mrossini-ethz/MidnightSun/led-driver-pcb/v1.0/led-driver.kicad_pcb

## KiCad design led-driver-pcb/v1.0/led-driver.kicad_pcb (2014-11-07)

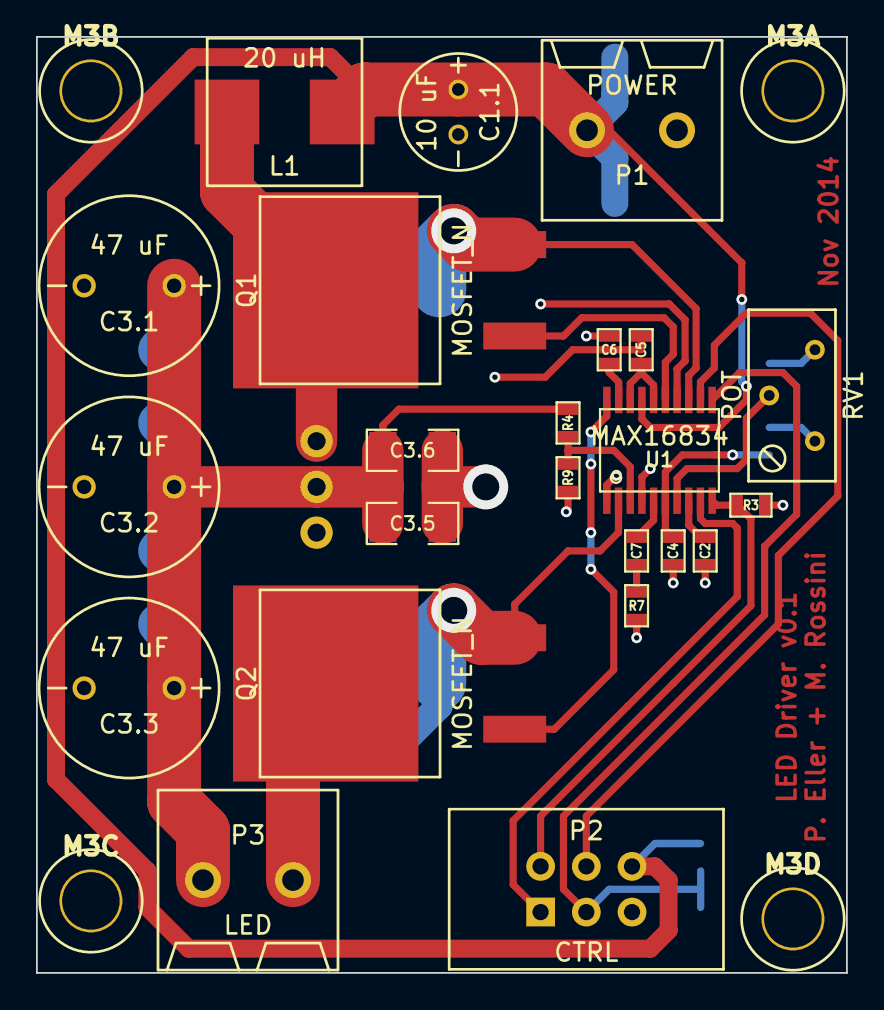
[picture p1: board led-driver.kicad_pcb from above]

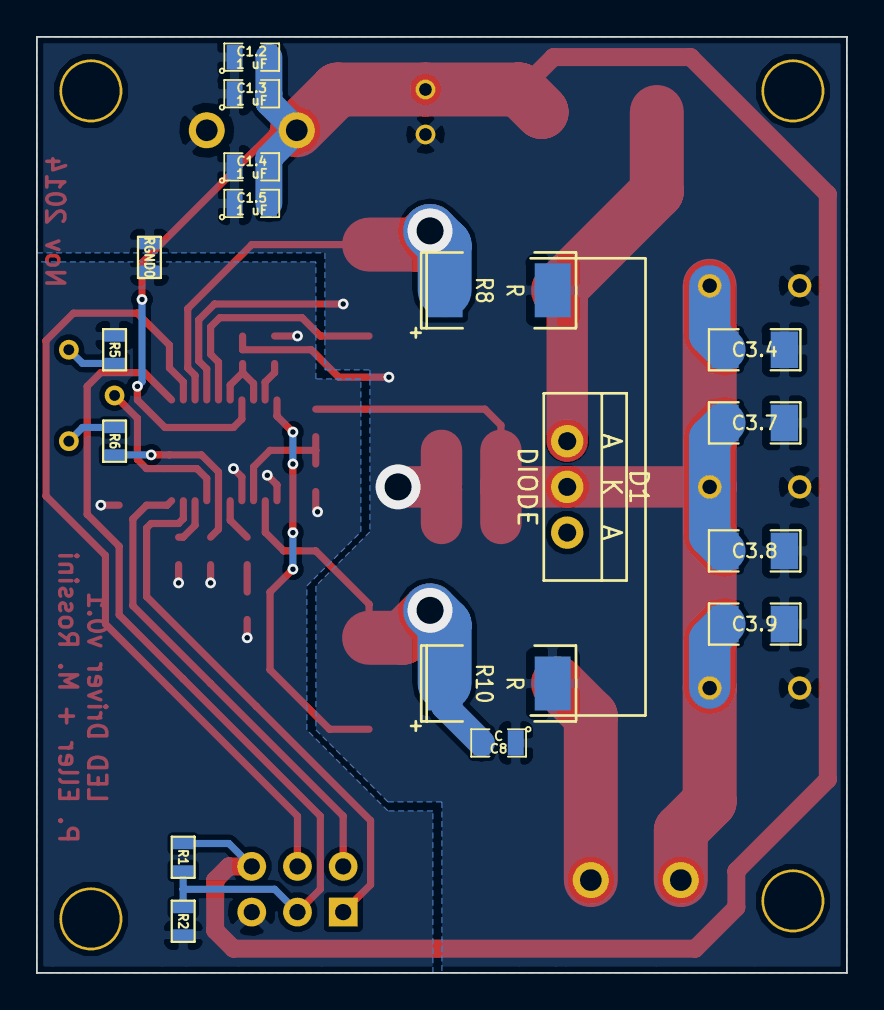
[picture p2: board led-driver.kicad_pcb from below]

Board: 2 copper layers, 45.0 x 52.0 mm, 44 parts (17 on the bottom side), 24 nets.

Parts:
C1.1: 10 uF; CP6.5x2.5
C1.2, C1.3, C1.4, C1.5: 1 uF; SM0805
C2, C4, C5, C6, C7: C; SM0603
C3.1, C3.2, C3.3: 47 uF; CP10x5
C3.4, C3.5, C3.6, C3.7, C3.8, C3.9: 1 uF; SM1206
C8: C; SM0805
D1: DIODE; TO220AB-Schottky
L1: 20 uH; LSMD8x8
M3A, M3B, M3C, M3D: P***; 1pin
P1: POWER; WAGO2P
P2: CTRL; PinHeader3x2
P3: LED; WAGO2P
Q1, Q2: MOSFET_N; D2PAK
R1, R2, R3, R4, R5, R6, R7, R9: R; SM0603
R8, R10: R; SM2512
RGND0: 0; SM0603
RV1: POT; RV_BOURNS
U1: MAX16834; tssop-20

Connections:
GND: C2.1, C4.1, C6.2, P2.5, R2.2, R3.2, R5.2, R7.2, R9.2, RGND0.2, U1.1, U1.4
GNDPWR: C1.1.2, C1.2.1, C1.3.1, C1.4.1, C1.5.1, C3.1.2, C3.2.2, C3.3.2, C3.4.1, C3.5.1, C3.6.1, C3.7.1, C3.8.1, C3.9.1, C5.2, C8.1, P1.1, R8.2, R10.2, RGND0.1, U1.14
unnamed: P2.4, U1.12
unnamed: R5.1, RV1.3
unnamed: C4.2, R6.1, U1.6
unnamed: P2.1, U1.9
unnamed: P2.2, R3.1, U1.10
unnamed: C2.2, U1.8
unnamed: RV1.2, U1.7
unnamed: R6.2, RV1.1
unnamed: P3.2, Q2.D
unnamed: P2.3, R1.2, R2.1, U1.11
unnamed: Q1.G, U1.15
unnamed: Q1.S, R8.1, U1.13
unnamed: Q2.G, U1.20
unnamed: R4.2, R9.1, U1.3
unnamed: C7.2, U1.5
unnamed: C7.1, R7.1
unnamed: C6.1, U1.19
unnamed: D1.1, L1.2, Q1.D
unnamed: C8.2, Q2.S, R10.1, U1.2
unnamed: C1.1.1, C1.2.2, C1.3.2, C1.4.2, C1.5.2, L1.1, P1.2, P2.6, R1.1, U1.17
unnamed: C5.1, U1.16, U1.18
unnamed: C3.1.1, C3.2.1, C3.3.1, C3.4.2, C3.5.2, C3.6.2, C3.7.2, C3.8.2, C3.9.2, D1.2, P3.1, R4.1
