mrossini-ethz/MidnightSun/firmware/cdc_pwm/led_ctrl.h

/*
             LUFA Library
     Copyright (C) Dean Camera, 2014.

  dean [at] fourwalledcubicle [dot] com
           www.lufa-lib.org
*/

/*
  Copyright 2014  Dean Camera (dean [at] fourwalledcubicle [dot] com)

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
  The author disclaims all warranties with regard to this
  software, including all implied warranties of merchantability
  and fitness.  In no event shall the author be liable for any
  special, indirect or consequential damages or any damages
  whatsoever resulting from loss of use, data or profits, whether
  in an action of contract, negligence or other tortious action,
  arising out of or in connection with the use or performance of
  this software.
*/

/** \file
 *
 *  Header file for VirtualSerial.c.
 */

#ifndef _VIRTUALSERIAL_H_
#define _VIRTUALSERIAL_H_

	/* Includes: */
		#include <avr/io.h>
		#include <avr/wdt.h>
		#include <avr/power.h>
		#include <avr/interrupt.h>
		#include <string.h>
		#include <stdio.h>

		#include "Descriptors.h"

		#include <LUFA/Drivers/USB/USB.h>
		#include <LUFA/Platform/Platform.h>

        #include <../../firmware/led-ctrl/macros.h>
        #include <../../firmware/led-ctrl/lookup.h>

	/* Macros: */
		/** LED mask for the library LED driver, to indicate that the USB interface is not ready. */
		#define LEDMASK_USB_NOTREADY      LEDS_LED1

		/** LED mask for the library LED driver, to indicate that the USB interface is enumerating. */
		#define LEDMASK_USB_ENUMERATING  (LEDS_LED2 | LEDS_LED3)

		/** LED mask for the library LED driver, to indicate that the USB interface is ready. */
		#define LEDMASK_USB_READY        (LEDS_LED2 | LEDS_LED4)

		/** LED mask for the library LED driver, to indicate that an error has occurred in the USB interface. */
		#define LEDMASK_USB_ERROR        (LEDS_LED1 | LEDS_LED3)

	/* Function Prototypes: */
		void SetupHardware(void);
        void cdc_receive(void);
		void EVENT_USB_Device_Connect(void);
		void EVENT_USB_Device_Disconnect(void);
		void EVENT_USB_Device_ConfigurationChanged(void);
		void EVENT_USB_Device_ControlRequest(void);

#endif
