mrossini-ethz/MidnightSun/(commit log)

2014-10-21 Added the current version of the boost converter simulation and a script to calculate the device values for it.
2014-10-21 Edited simulation and parameter script to match the 24 V power supply specs.
2014-10-21 Added a KiCAD project and the schematic for the LED driver.
    [led-driver.sch]
2014-10-22 updated values in schema
    [led-driver.sch]
2014-10-31 Added the MOSFET component datasheet.
2014-10-31 Added footprints to the PCB of the LED driver and set up the PCB design.
    [led-driver.kicad_pcb, led-driver.sch]
2014-11-02 arranged components on PCB
    [led-driver.kicad_pcb]
2014-11-02 updated components on PCB
    [led-driver.kicad_pcb]
2014-11-02 Added a 3x2 pin header to the footprint library.
2014-11-02 Added power ratings for resistors in parameter calculater.
2014-11-03 Added components list for LED driver PCB.
2014-11-03 updated layout, added screwholes
    [led-driver.kicad_pcb]
2014-11-03 Finished the PCB design.
    [led-driver.kicad_pcb]
2014-11-04 Improved the params file for the LED driver by rounding values and adding more component values.
2014-11-04 added pwrgnd layer
    [led-driver.kicad_pcb, led-driver.sch]
2014-11-04 Optimized design and put capacitor C1.1 also to power ground.
    [led-driver.kicad_pcb, led-driver.sch]
2014-11-04 Made more optimizations.
    [led-driver.kicad_pcb, led-driver.sch]
2014-11-04 Enhanced the LED driver parameter script to show temperatures of components.
2014-11-04 Added calculation of capacitor ripple currents and added some component suggestions.
    [led-driver.sch]
2014-11-05 Exchanged capacitors and added new ones to allow for current ripple and to minimize ESR.
    [led-driver.kicad_pcb, led-driver.sch]
2014-11-05 Corrected the footprint of the MOSFETs.
    [led-driver.kicad_pcb]
2014-11-07 Moved two ceramic capacitors closer to the diode.
    [led-driver.kicad_pcb]
2014-12-03 added firmware project; first version of PWM
2014-12-15 Added an intensity lookup table to smoothly control the LED intensity.
2014-12-16 Firmware: Changed PWM mode to phase correct such that 0 % and 100 % duty cycle are possible.
    [main.c]
2015-02-16 Added a macros.h header file to simplify the setting of flags in registers and the handling of GPIO pins. Converted project to the Arduino Uno/Leonardo at the same time.
2015-02-17 Added a USART interface that at the moment just echos the input. Had to fix the system clock prescaling that was previously broken while doing so.
    [interrupt.c, interrupt.h, main.c, usart.c, usart.h]
2015-02-21 Changed the PWM control from fixed frequency to variable frequency below a certain threshold intensity. This enhances resolution at the low end.
    [main.c, usart.c]
2015-05-18 arduino leonardo lufa
2015-05-21 Added the Arduino Boards to the payment list.
2015-05-21 Added wishlist for LED driver v2
2015-05-21 Updated driver wishlist
